SubhraJyotiDey/SmartTank-Dissertation/figures/system_schematic.png

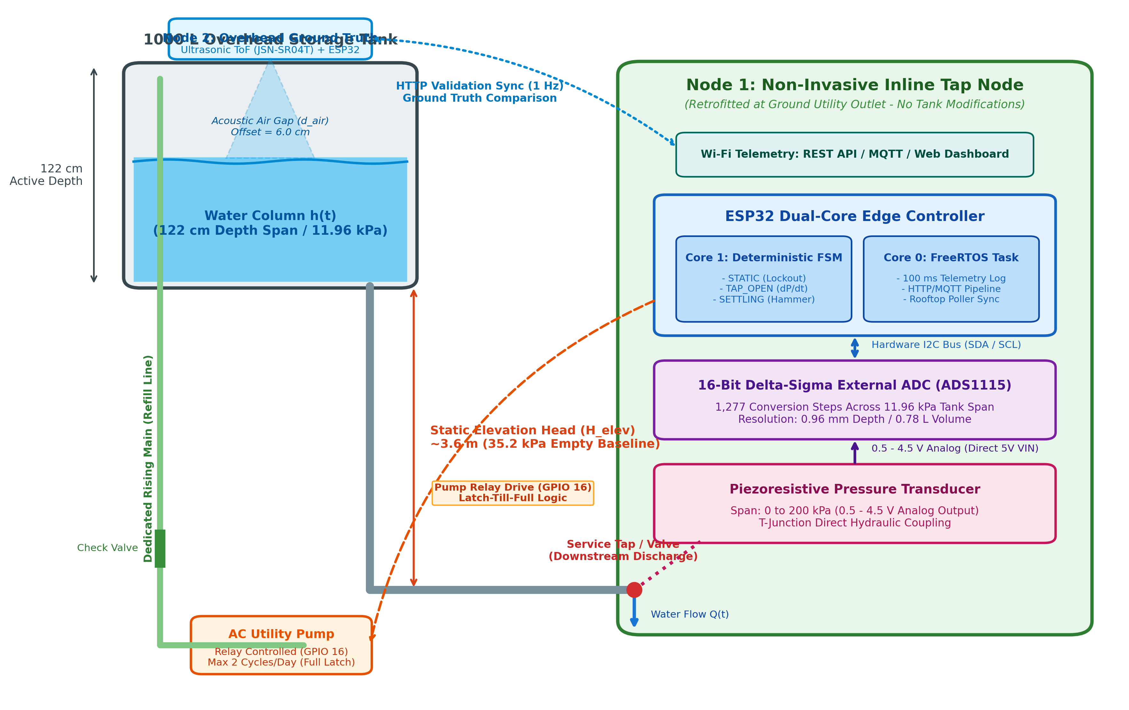
figures/system_schematic.png
