SubhraJyotiDey/SmartTank-Dissertation/plots/highres_events/00_master_highres_events_comparison.png

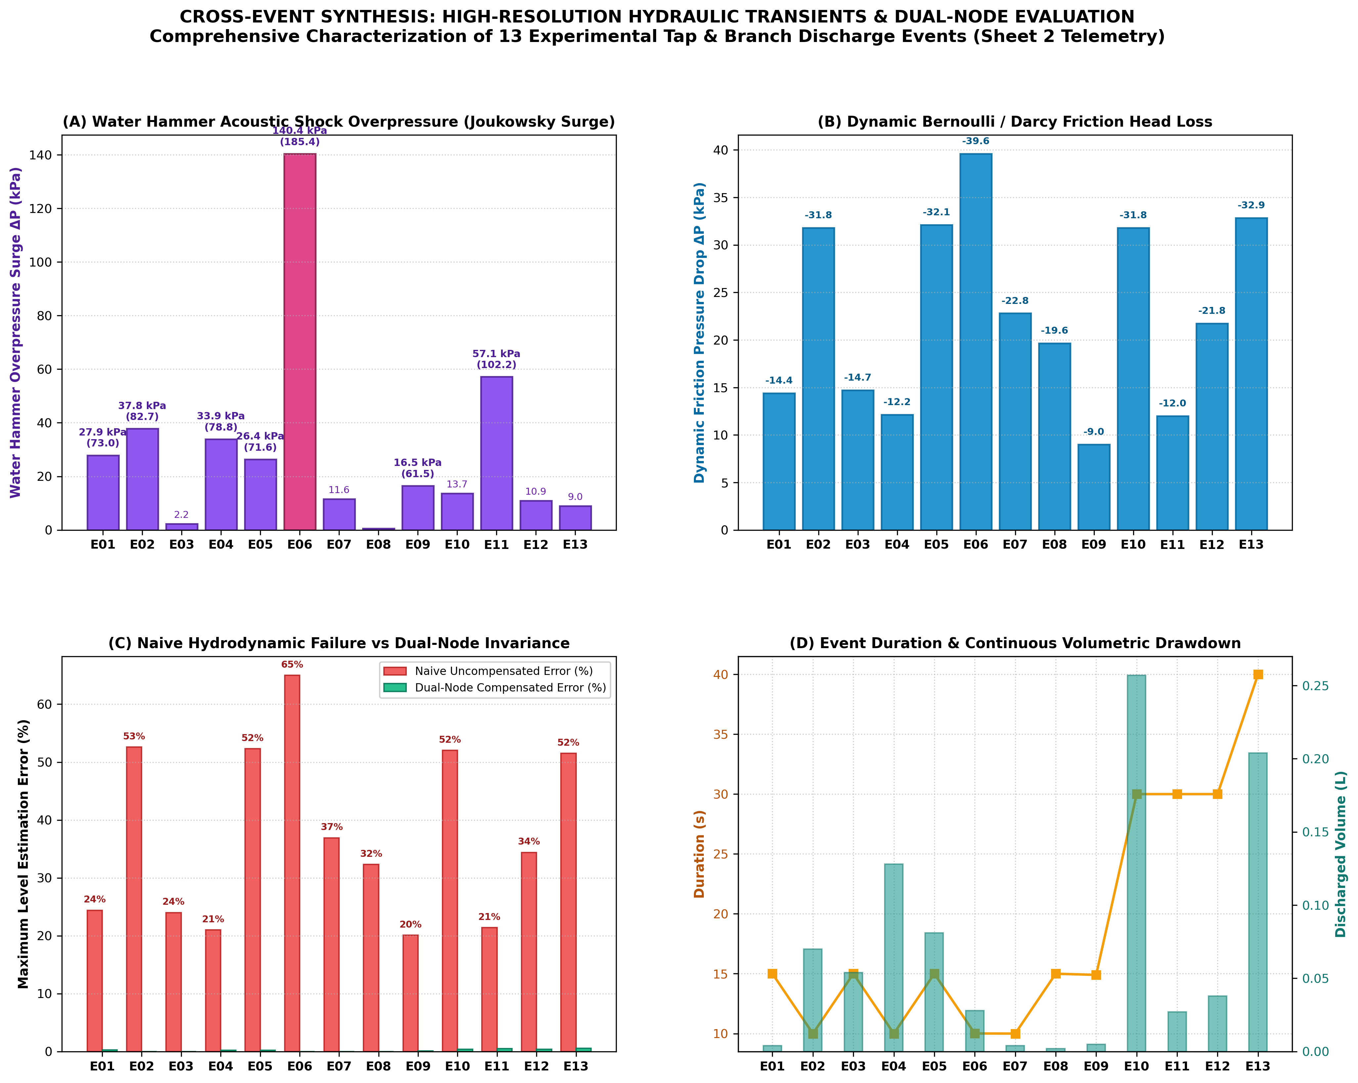
plots/highres_events/00_master_highres_events_comparison.png
