SubhraJyotiDey/SmartTank-Dissertation/plots/highres_events/event_01_EVT_1198_node_tap-1_open_only_5.png

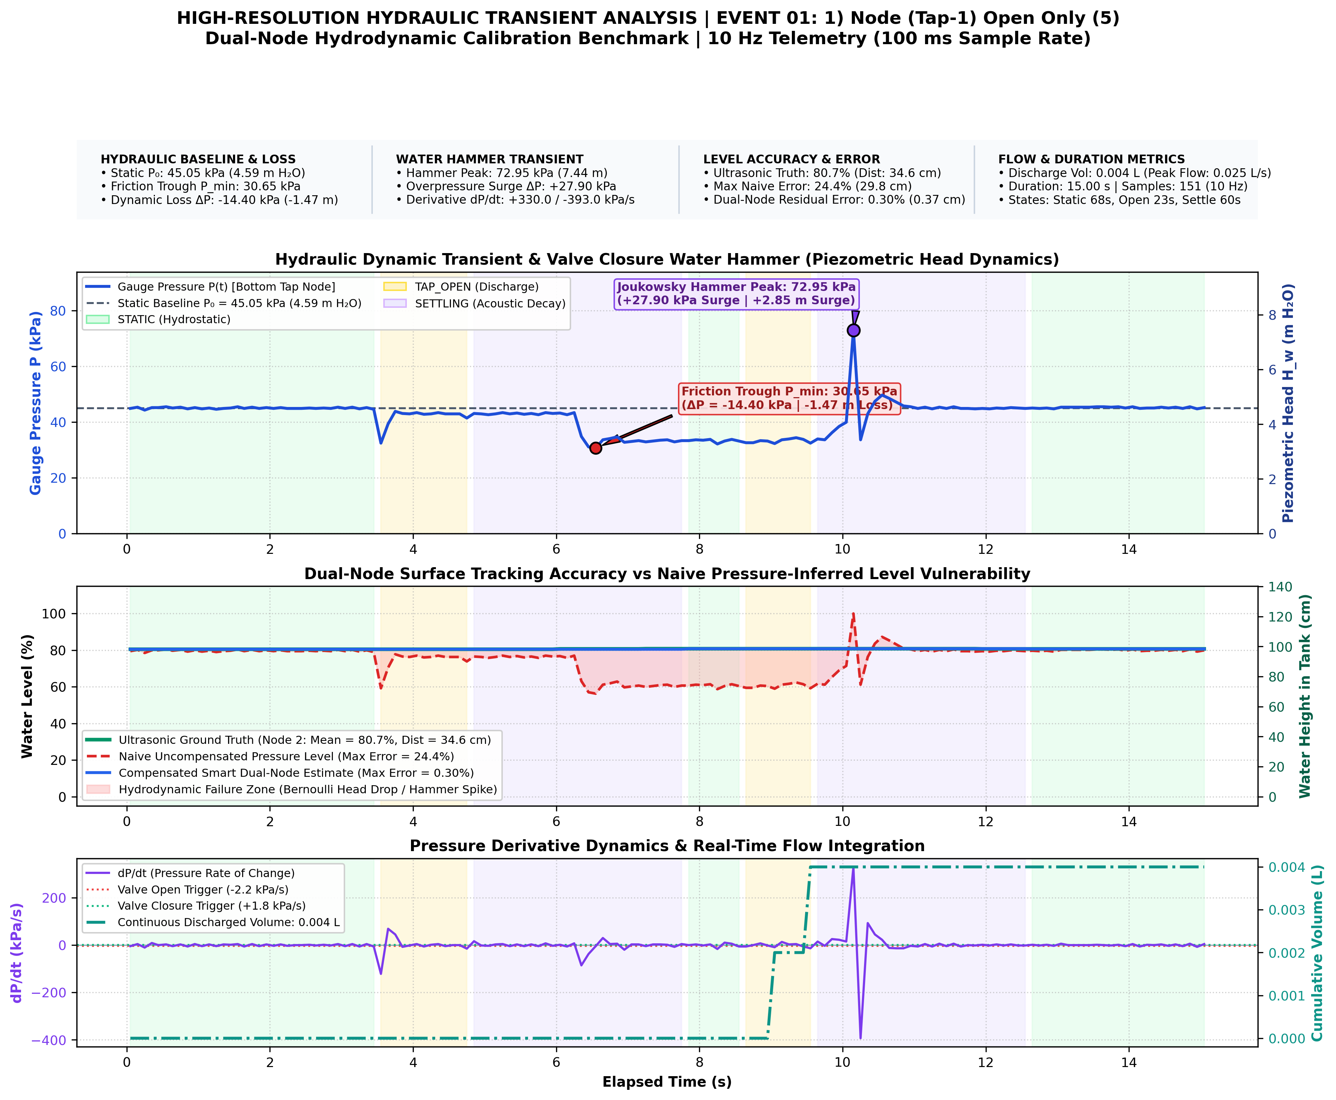
plots/highres_events/event_01_EVT_1198_node_tap-1_open_only_5.png
