SubhraJyotiDey/SmartTank-Dissertation/plots/highres_events/event_02_EVT_1728_node_tap-1_open_only_m.png

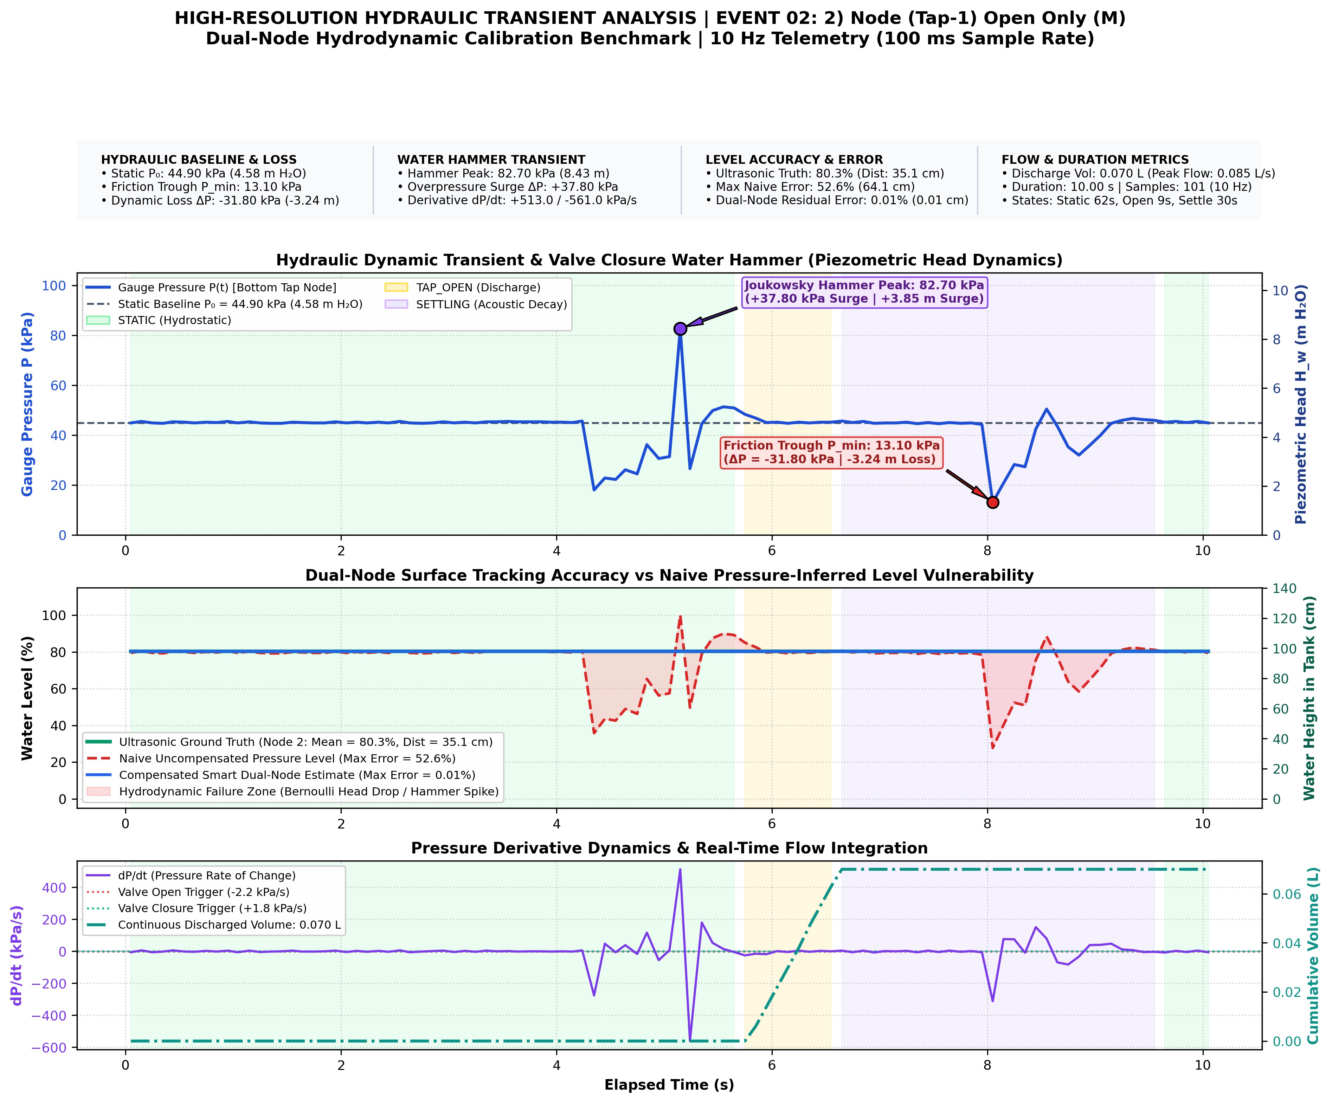
plots/highres_events/event_02_EVT_1728_node_tap-1_open_only_m.png
