SubhraJyotiDey/SmartTank-Dissertation/plots/highres_events/event_03_EVT_1934_tap-2_open_only_5s.png

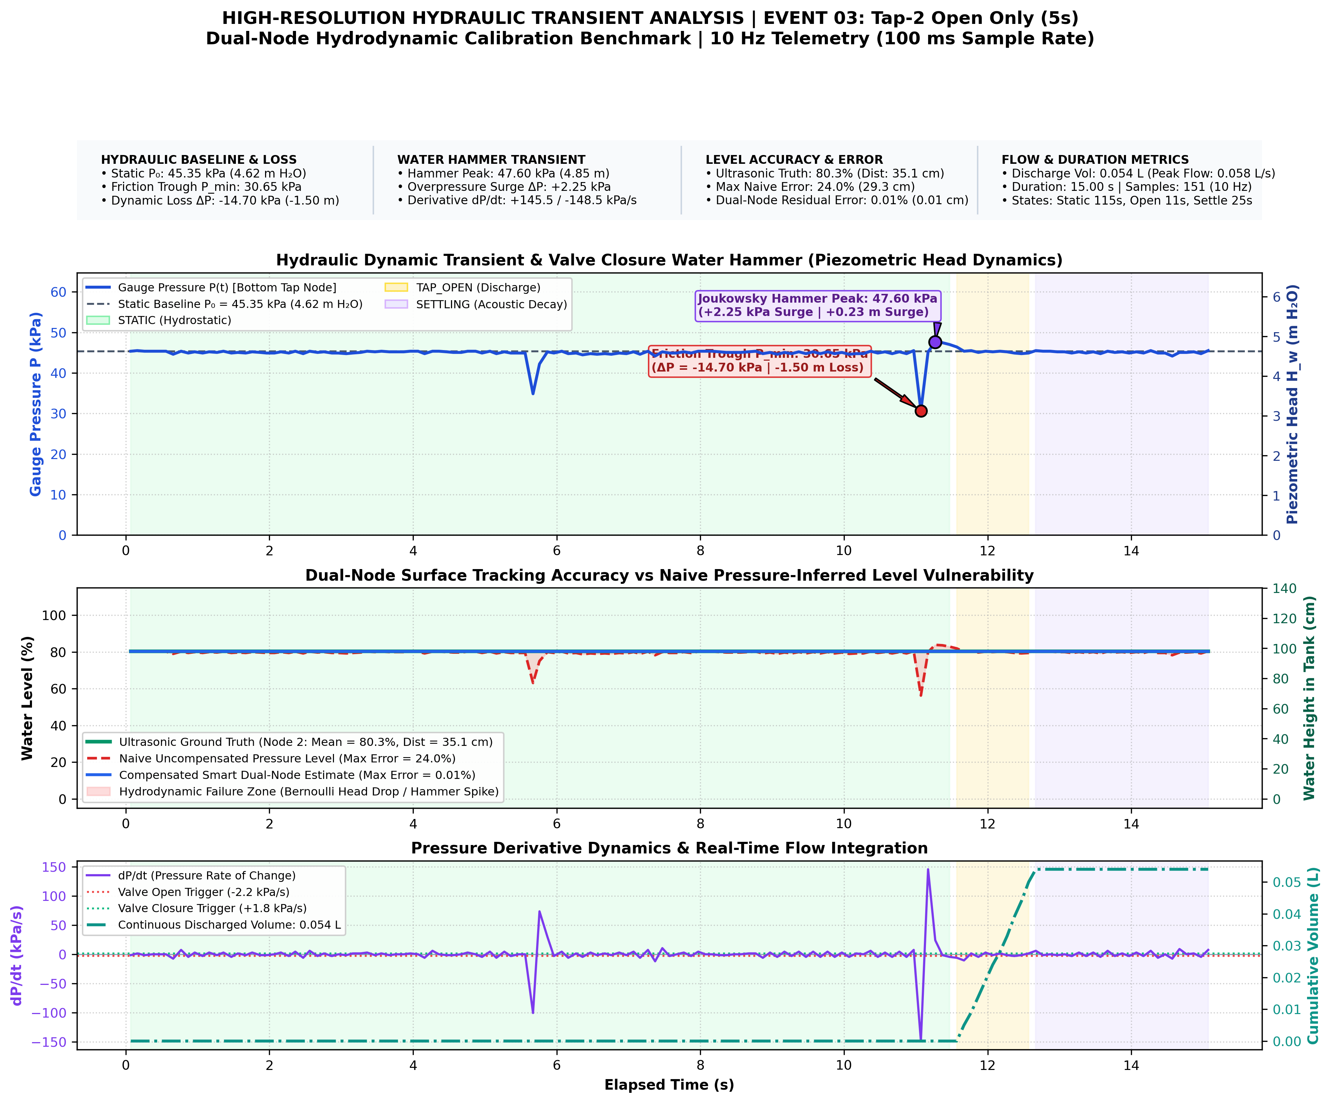
plots/highres_events/event_03_EVT_1934_tap-2_open_only_5s.png
