SubhraJyotiDey/SmartTank-Dissertation/plots/highres_events/event_04_EVT_1979_tap-2_open_only_m.png

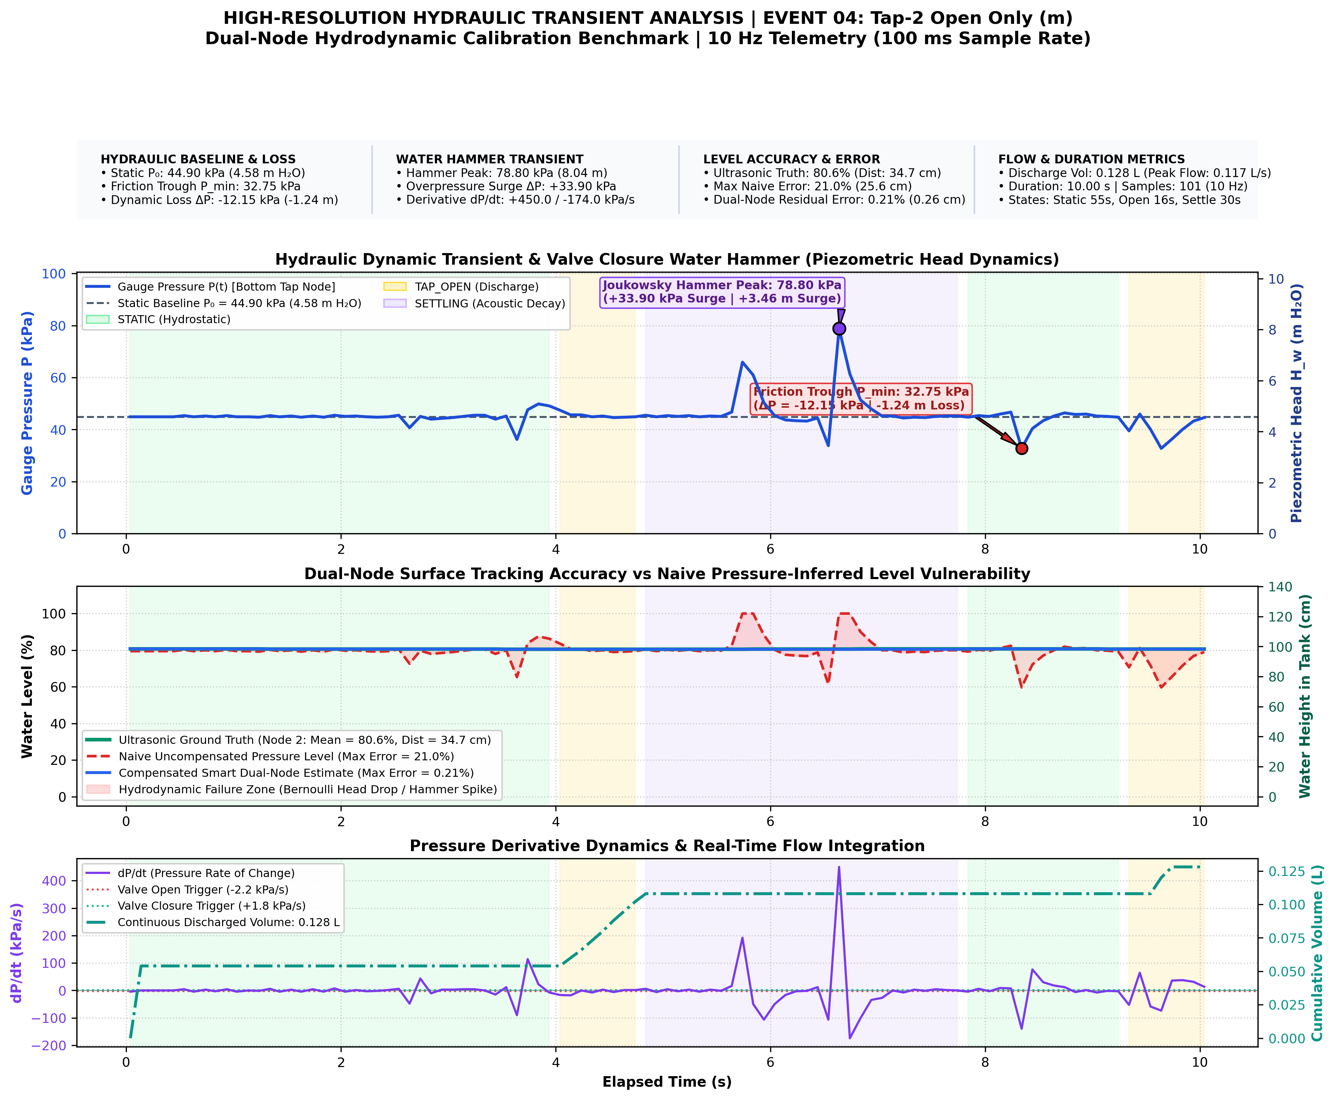
plots/highres_events/event_04_EVT_1979_tap-2_open_only_m.png
