SubhraJyotiDey/SmartTank-Dissertation/plots/highres_events/event_05_EVT_2163_both_taps_open_5s.png

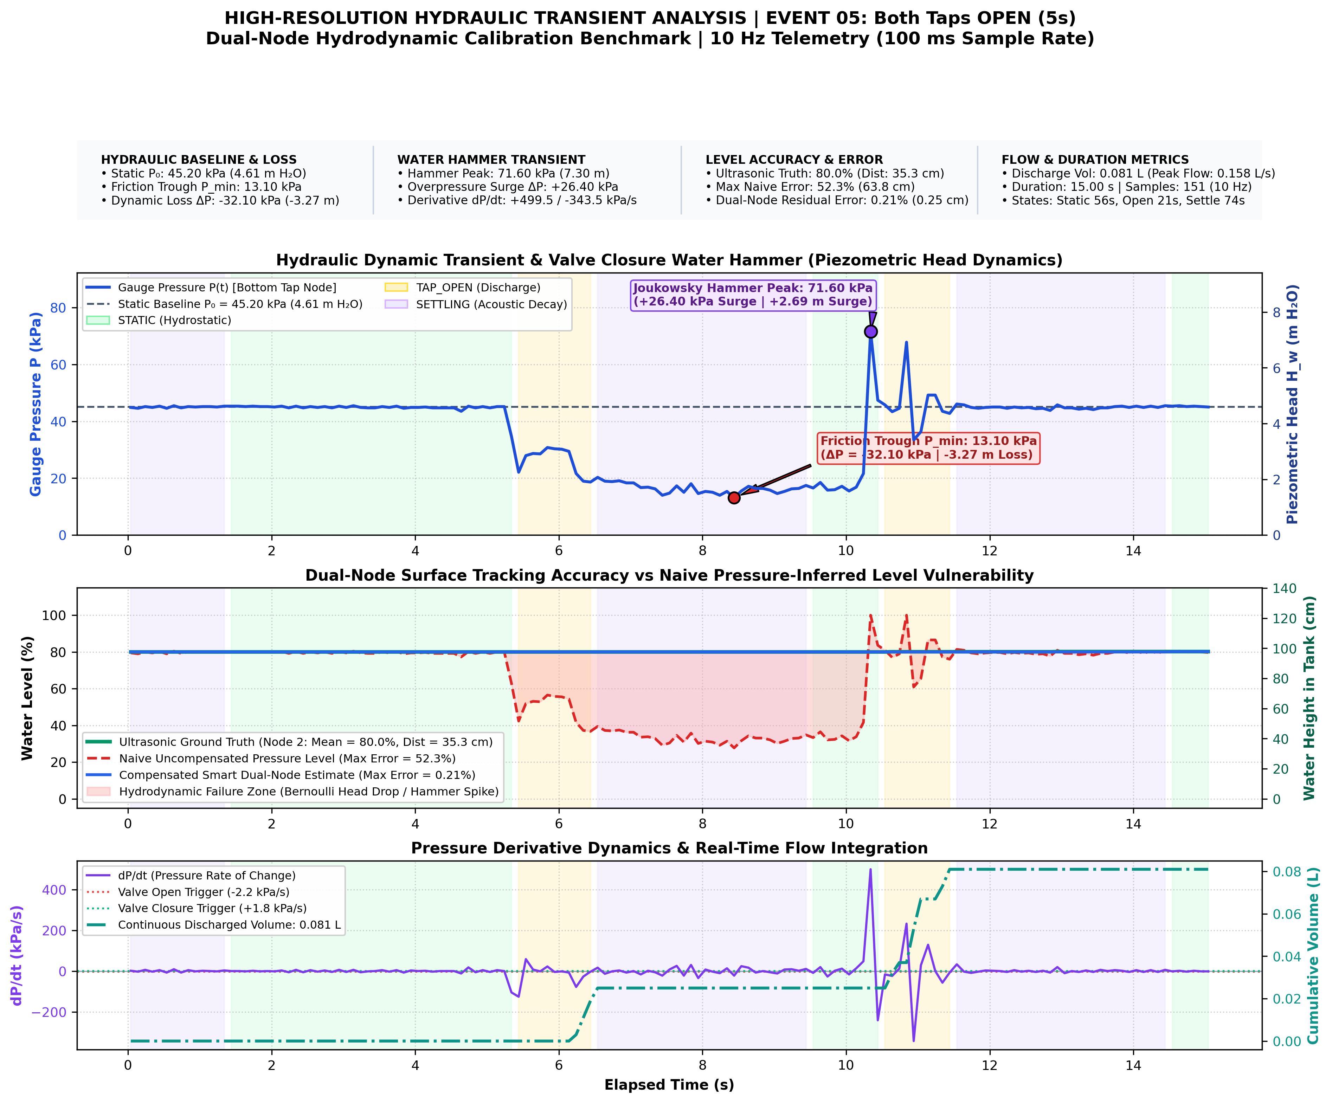
plots/highres_events/event_05_EVT_2163_both_taps_open_5s.png
