SubhraJyotiDey/SmartTank-Dissertation/plots/highres_events/event_06_EVT_2470_both_taps_open_m.png

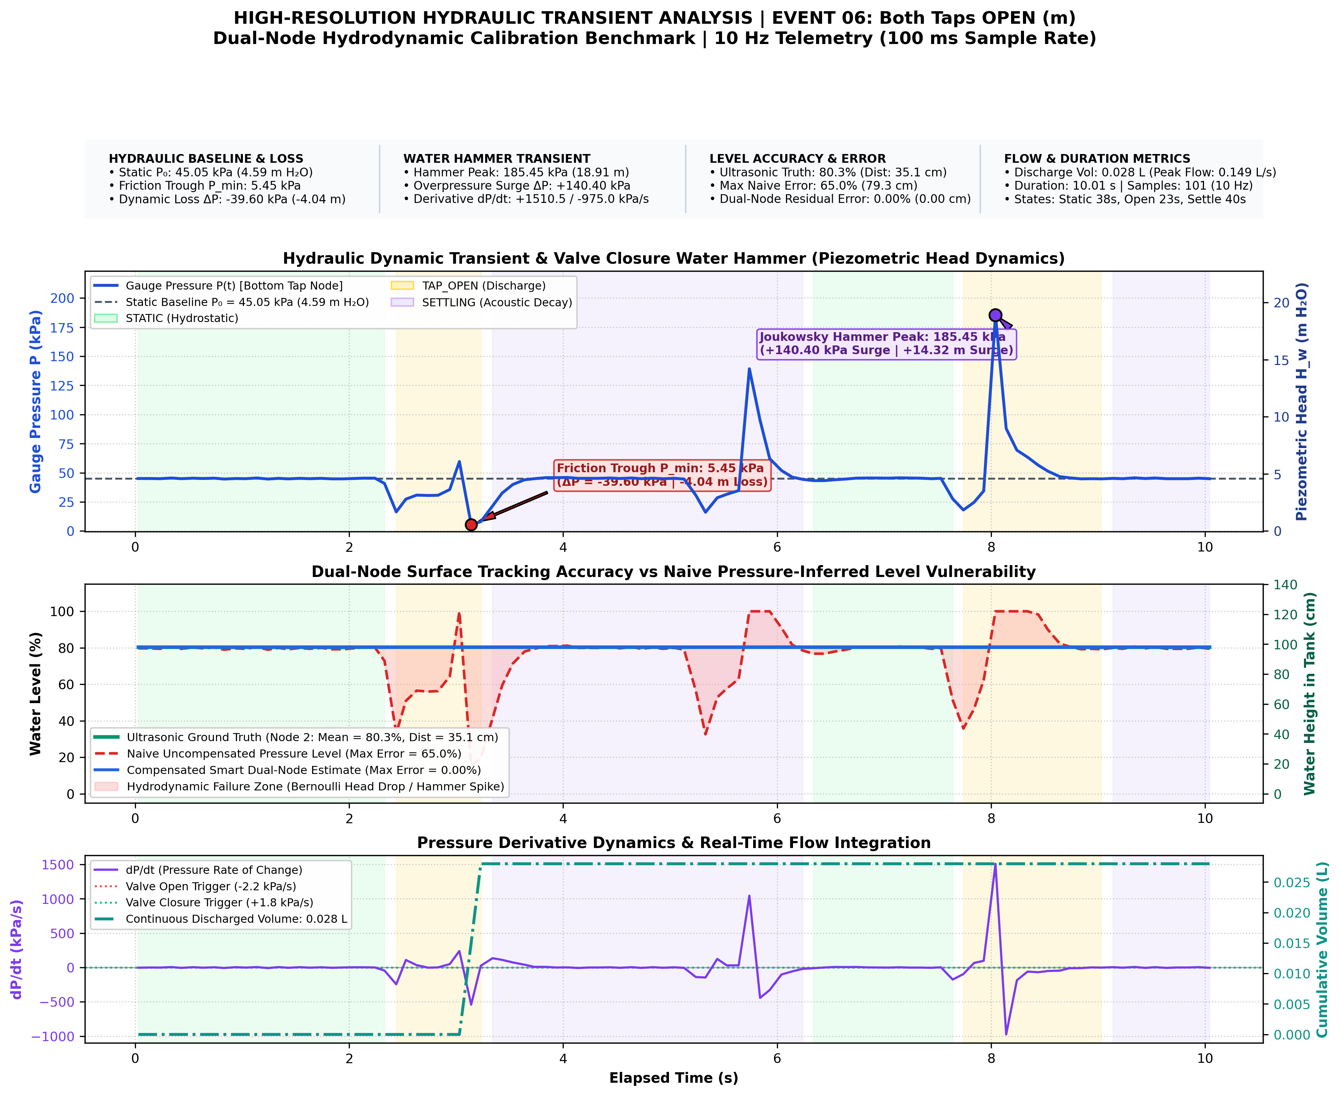
plots/highres_events/event_06_EVT_2470_both_taps_open_m.png
