SubhraJyotiDey/SmartTank-Dissertation/plots/highres_events/event_07_EVT_2779_branch_2_open_m.png

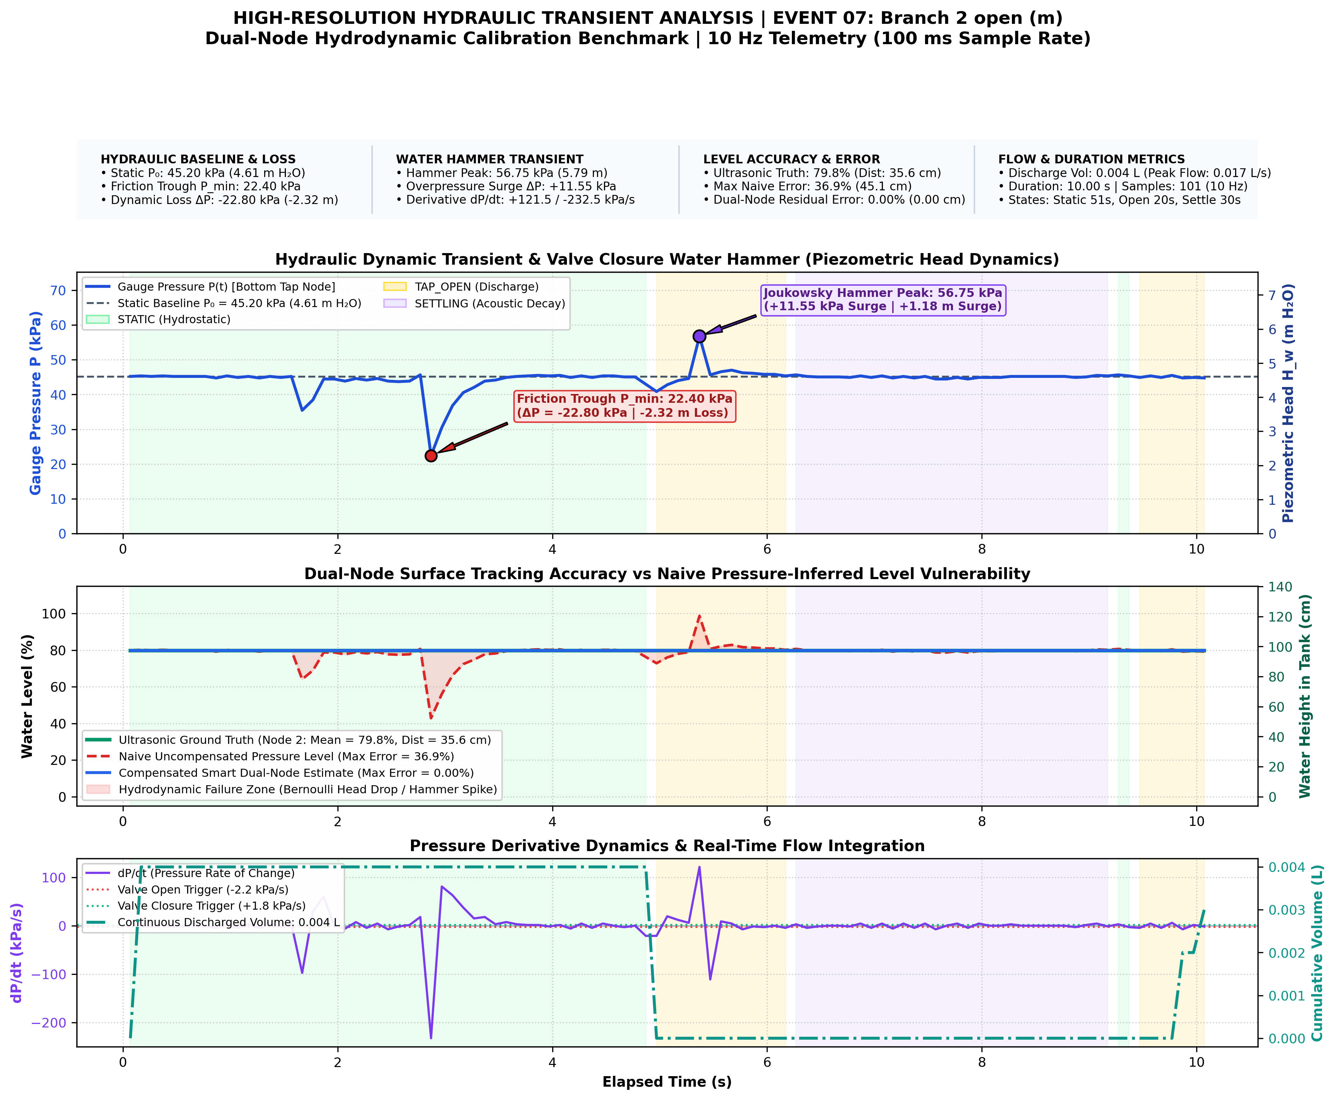
plots/highres_events/event_07_EVT_2779_branch_2_open_m.png
