SubhraJyotiDey/SmartTank-Dissertation/plots/highres_events/event_08_EVT_3347_branch_2_open_5s.png

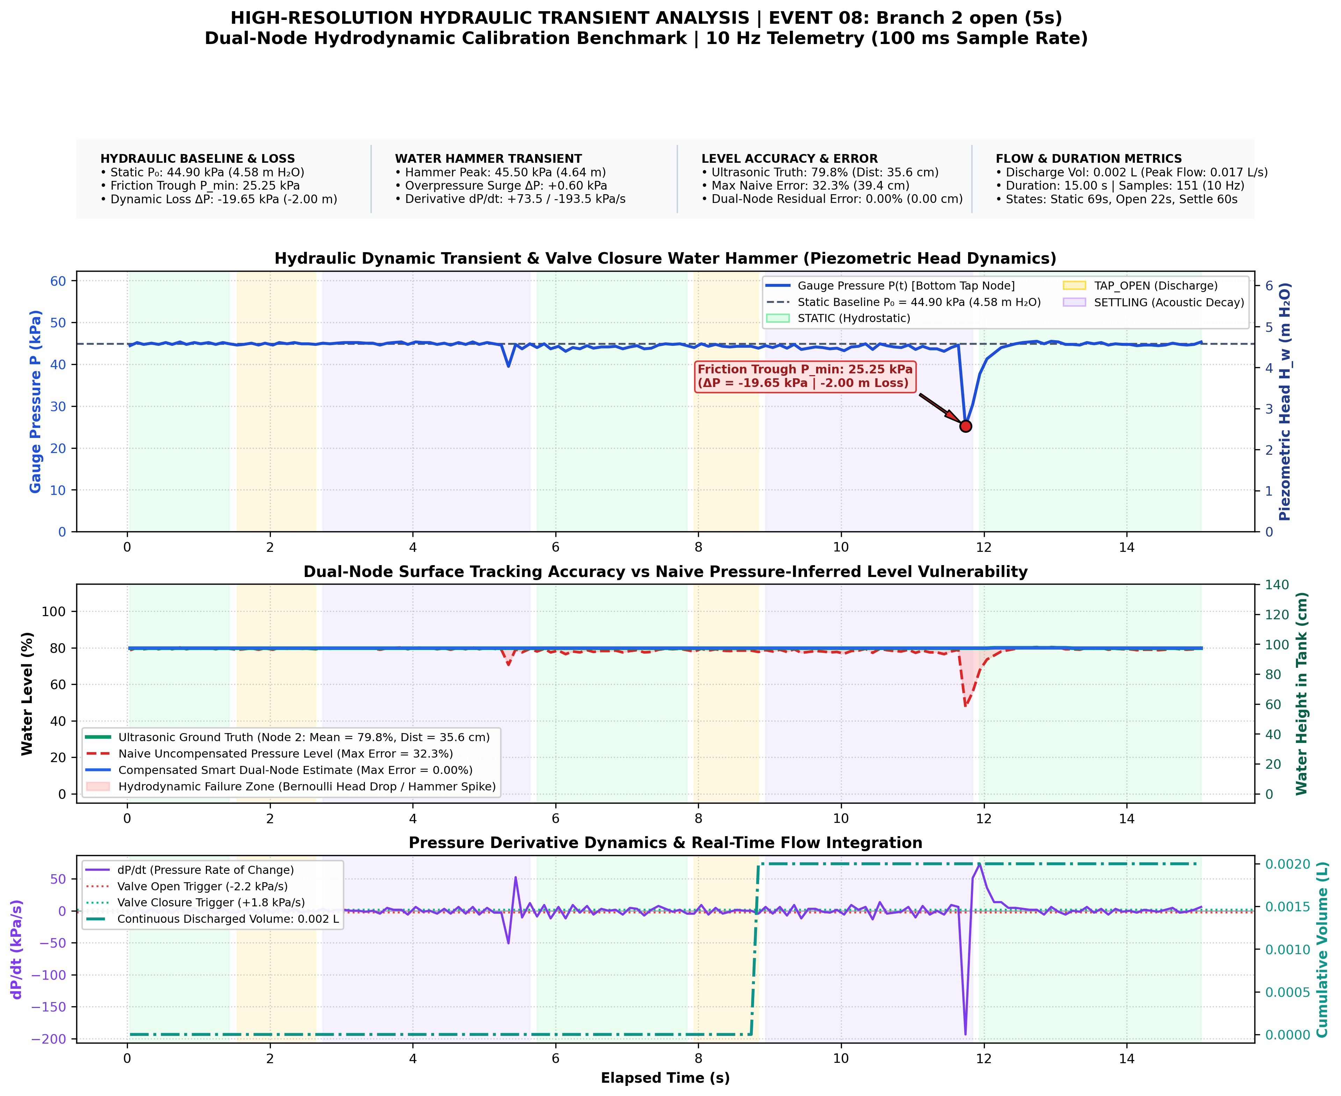
plots/highres_events/event_08_EVT_3347_branch_2_open_5s.png
