SubhraJyotiDey/SmartTank-Dissertation/plots/highres_events/event_09_EVT_3409_branch_3_basin_open_5s.png

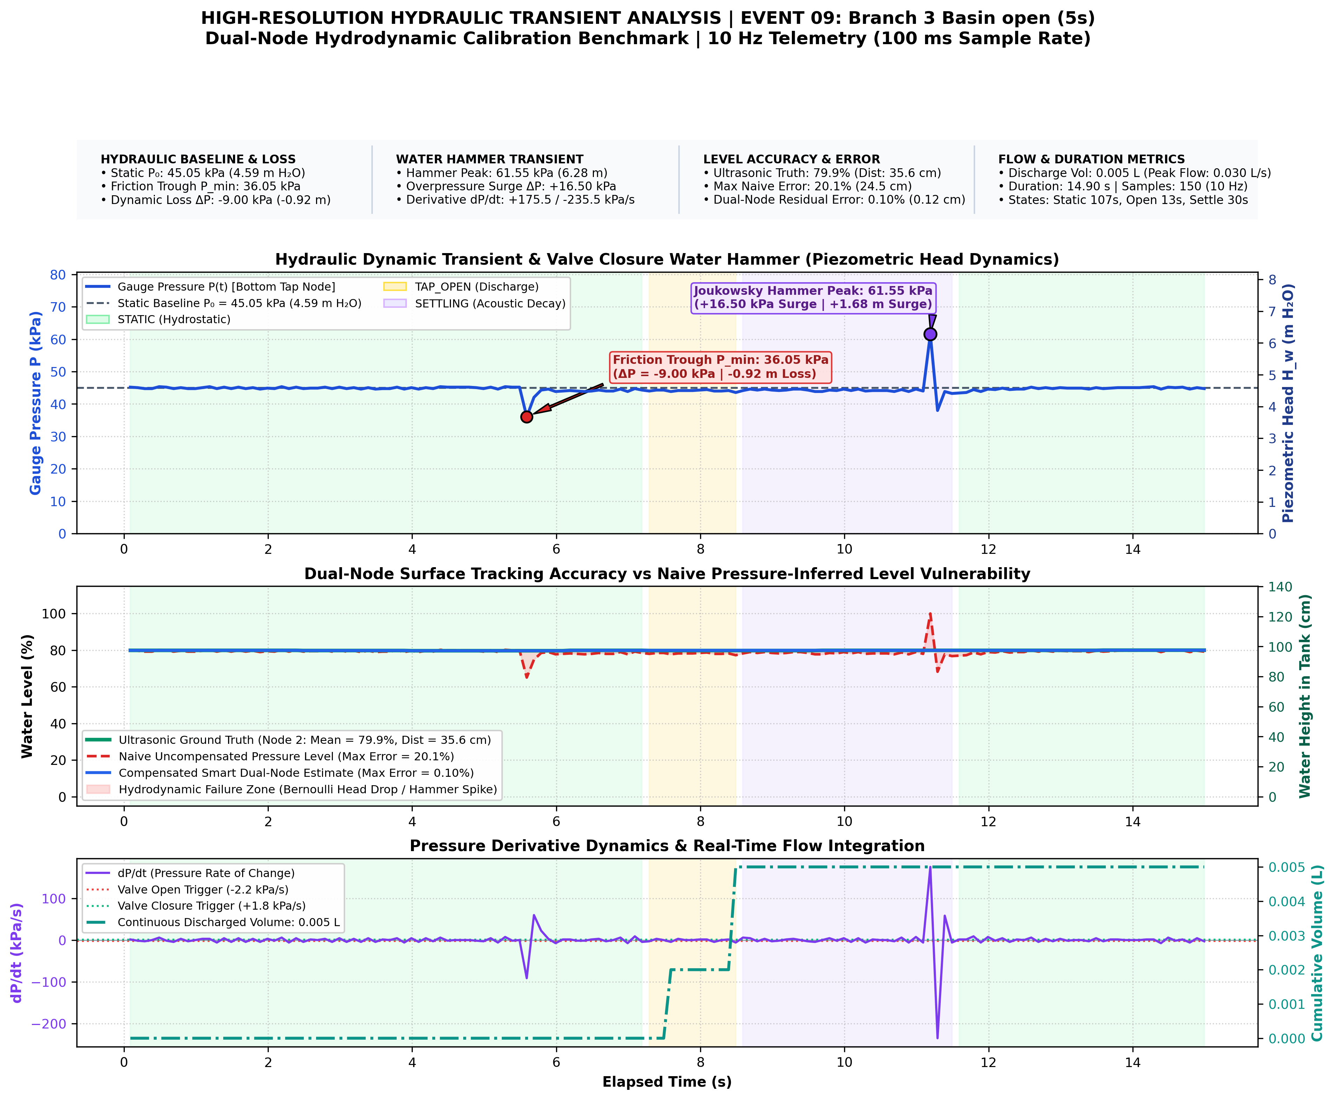
plots/highres_events/event_09_EVT_3409_branch_3_basin_open_5s.png
