SubhraJyotiDey/SmartTank-Dissertation/plots/highres_events/event_10_EVT_3598_all_branches_open_20s.png

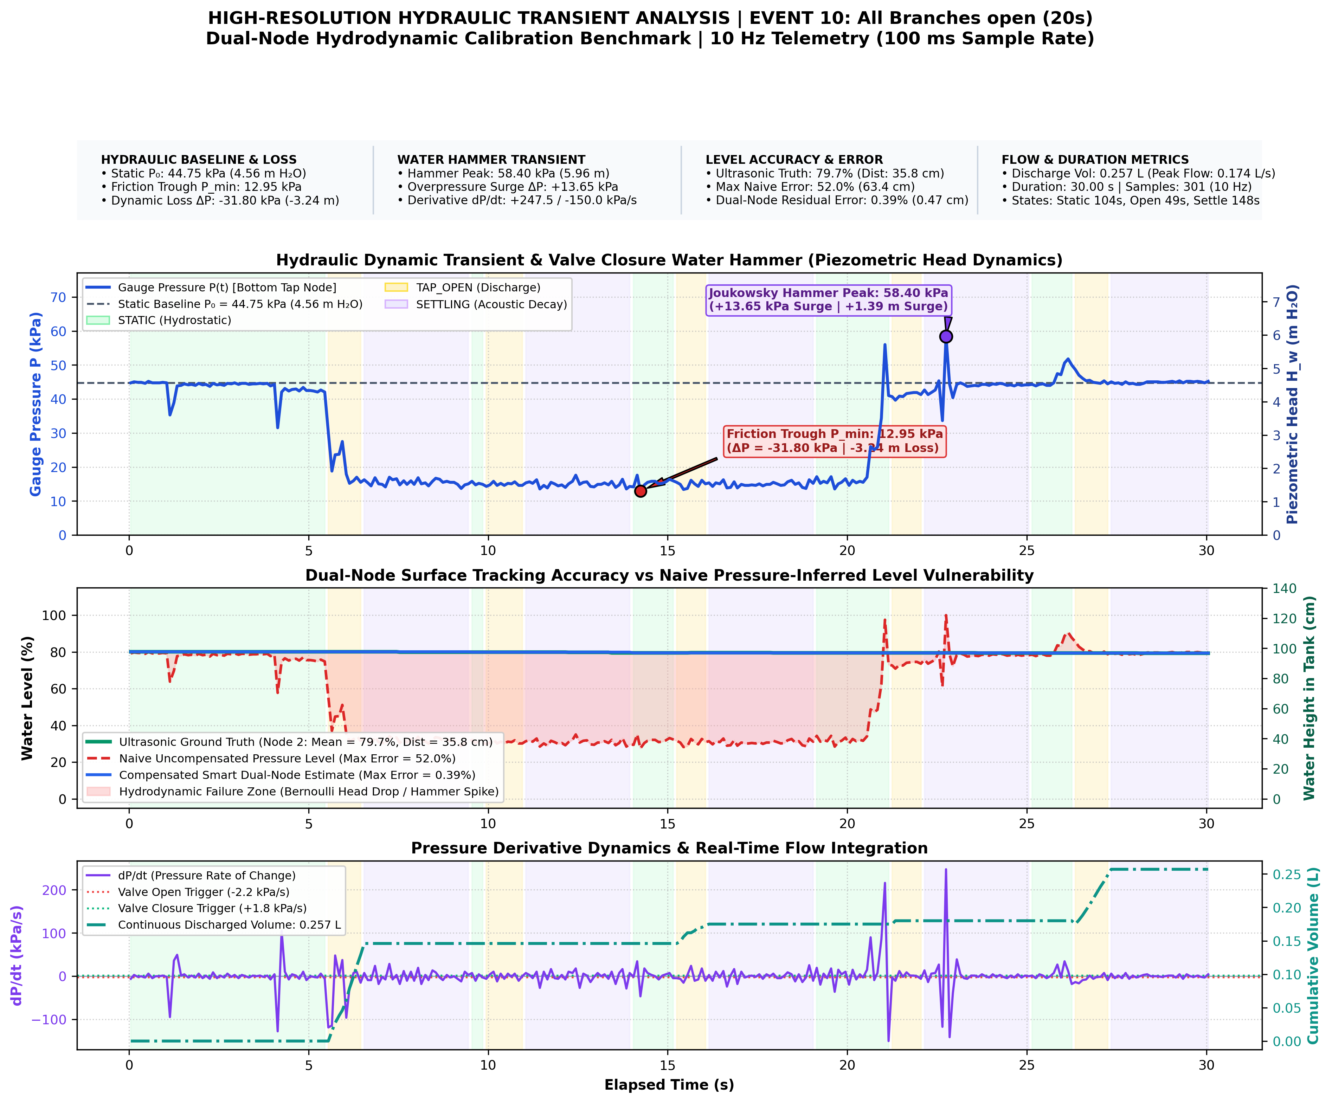
plots/highres_events/event_10_EVT_3598_all_branches_open_20s.png
