SubhraJyotiDey/SmartTank-Dissertation/plots/highres_events/event_11_EVT_3949_branch_2-3_open_10s.png

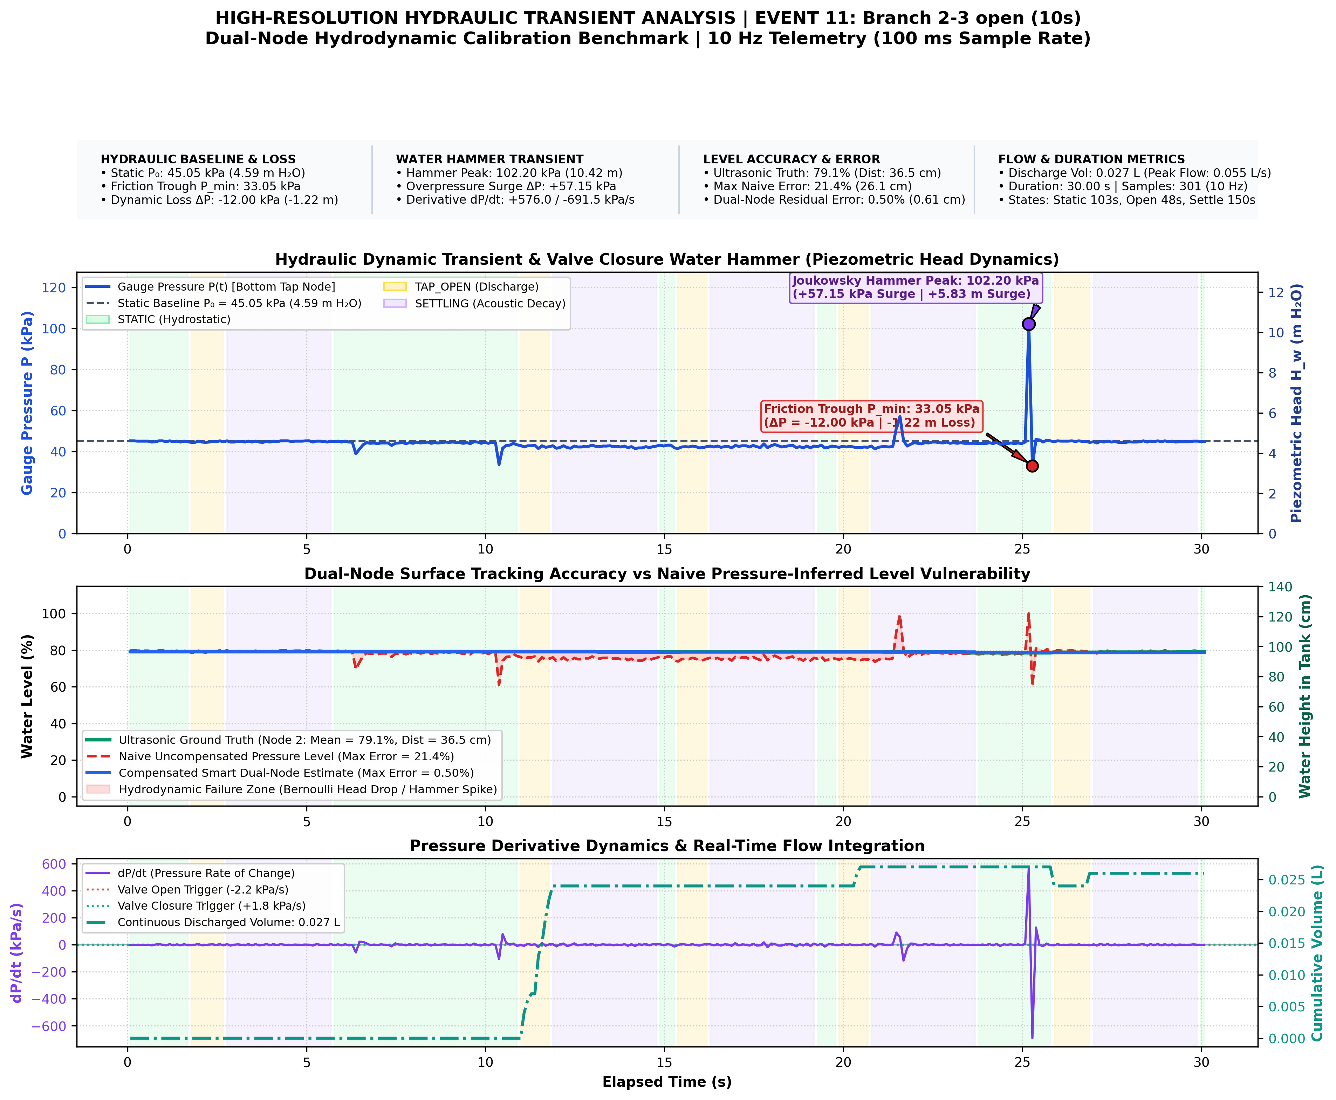
plots/highres_events/event_11_EVT_3949_branch_2-3_open_10s.png
