SubhraJyotiDey/SmartTank-Dissertation/plots/highres_events/event_12_EVT_4065_branch_1-2_open_10s.png

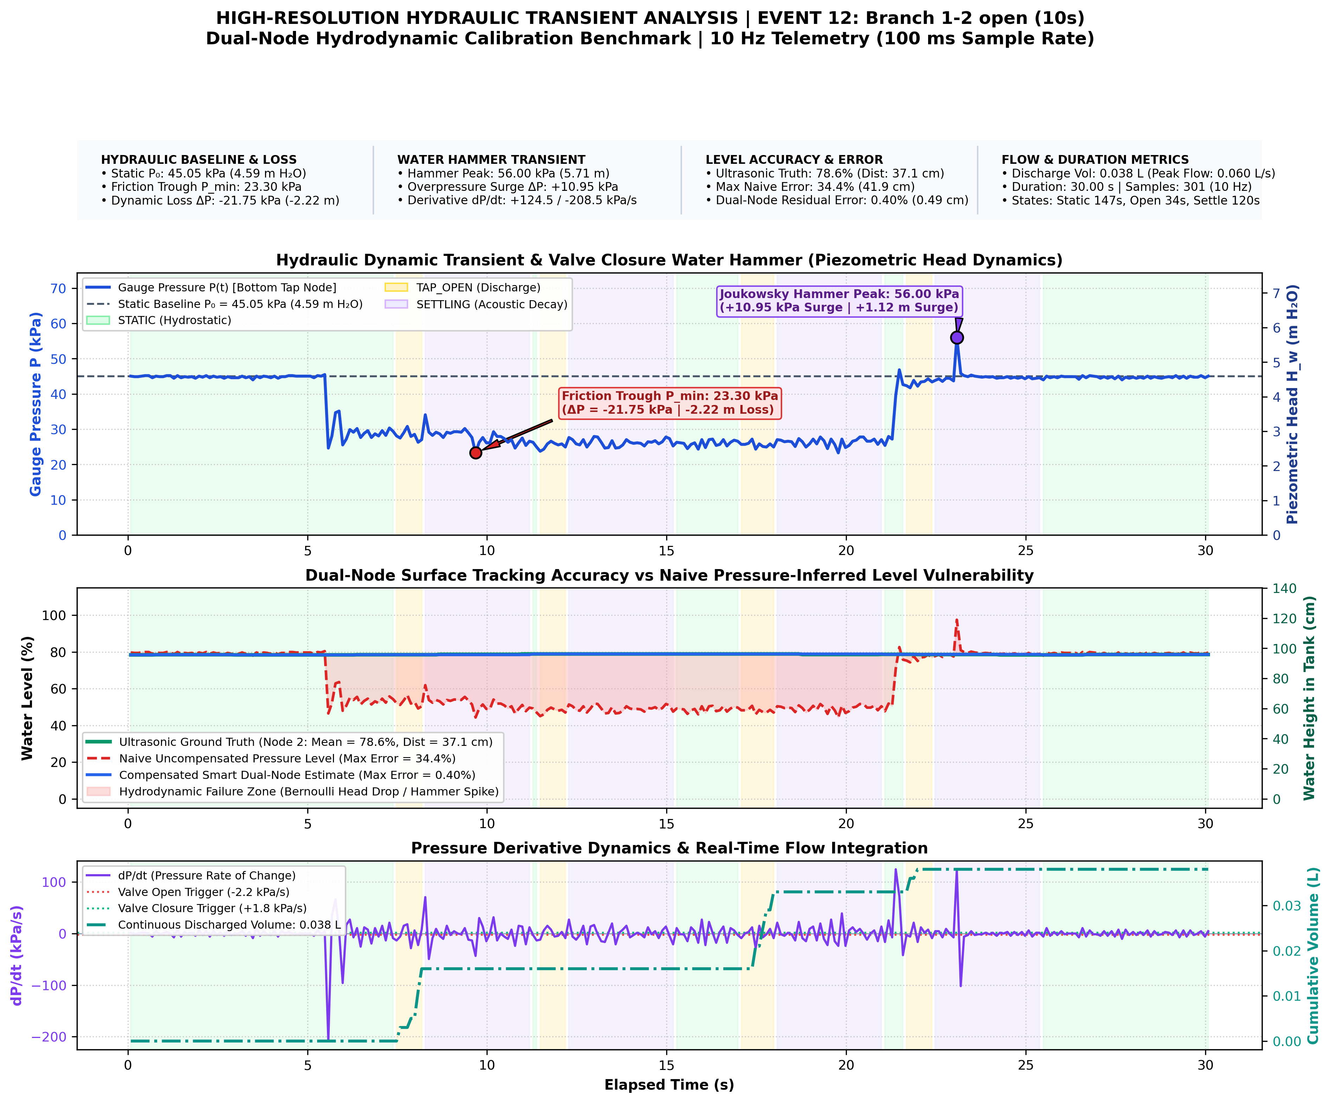
plots/highres_events/event_12_EVT_4065_branch_1-2_open_10s.png
