SubhraJyotiDey/SmartTank-Dissertation/plots/highres_events/event_13_EVT_4303_branch_1-3_open_10s.png

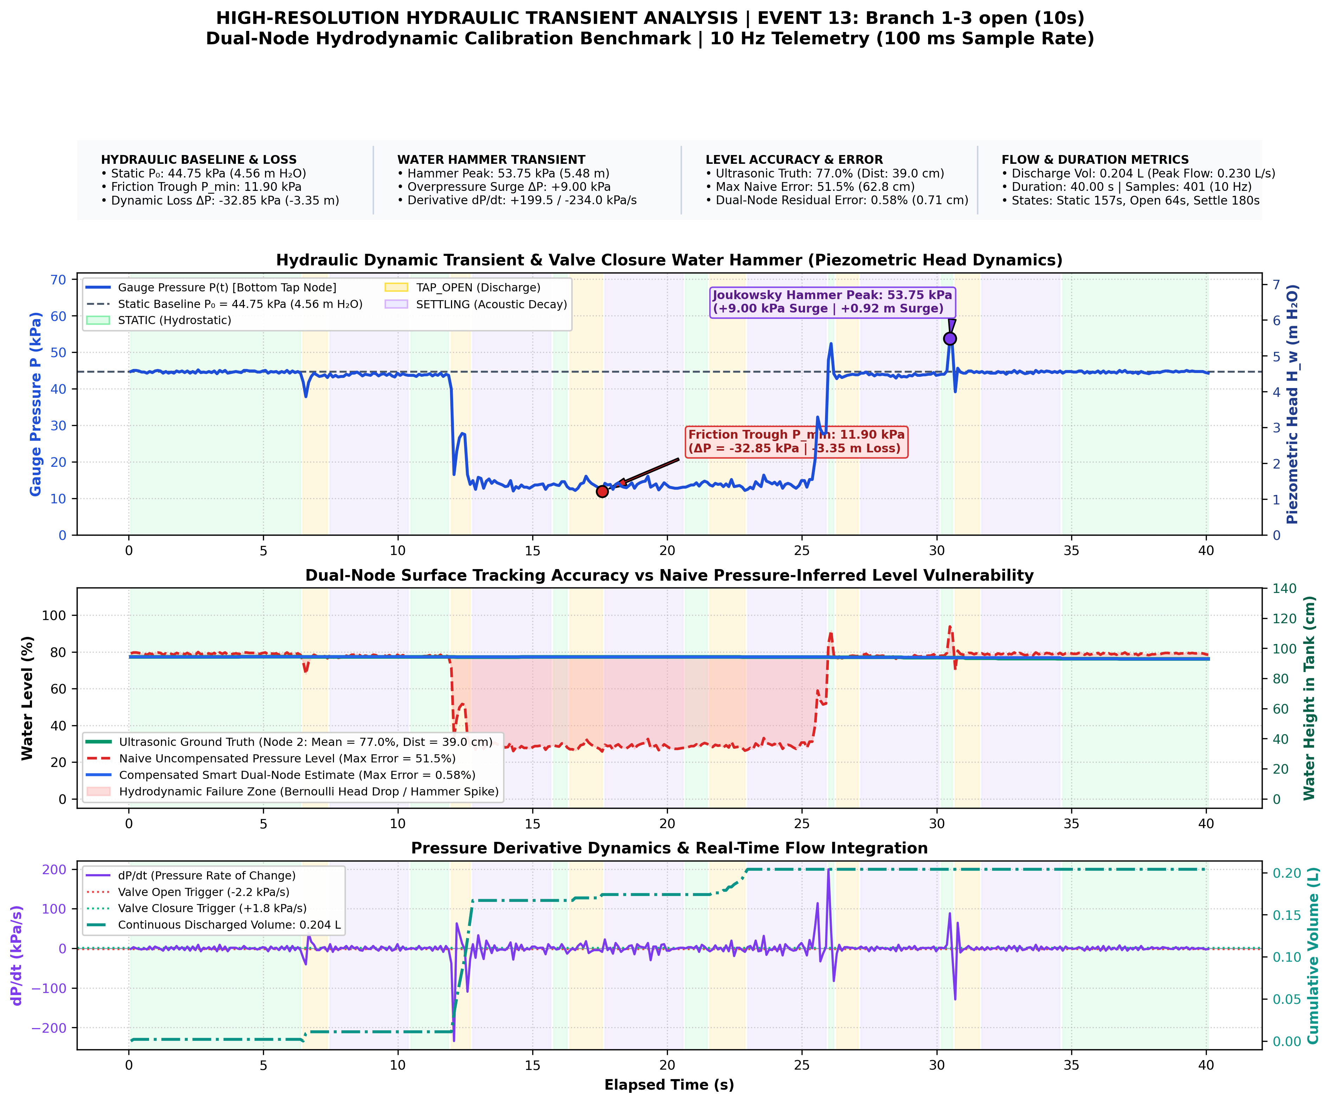
plots/highres_events/event_13_EVT_4303_branch_1-3_open_10s.png
