SubhraJyotiDey/SmartTank-Dissertation/system_block_diagram.png

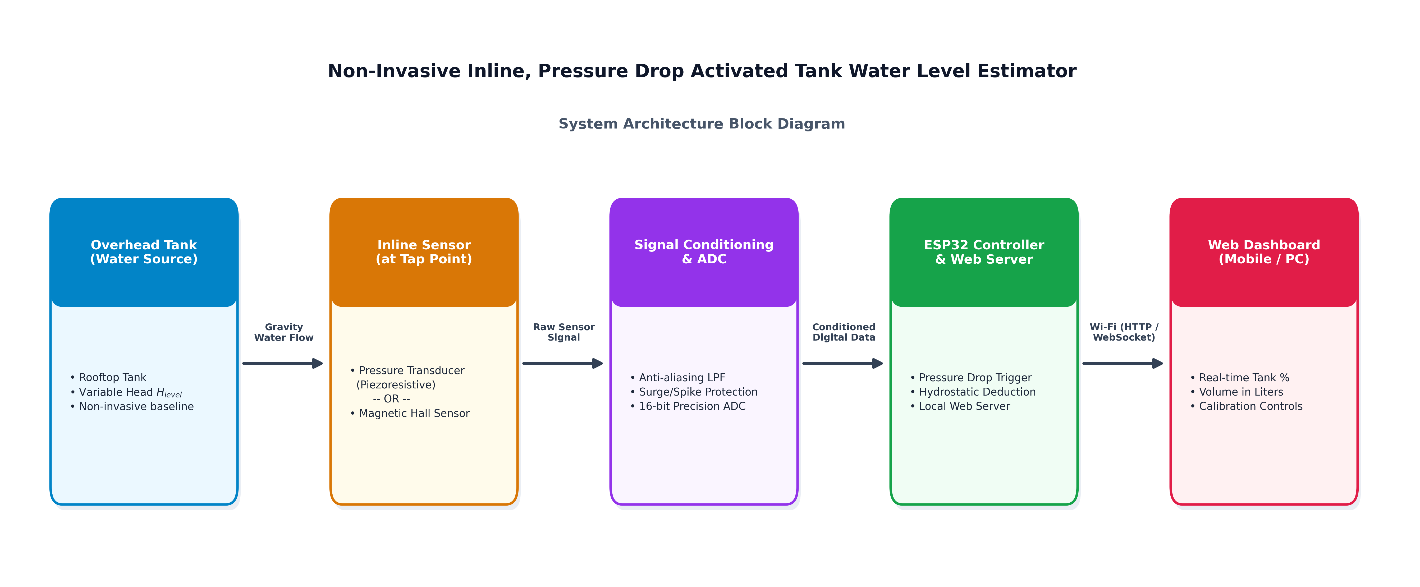
system_block_diagram.png
