SubhraJyotiDey/SmartTank-Dissertation/water_level_comparison_rows_1138_1474.png

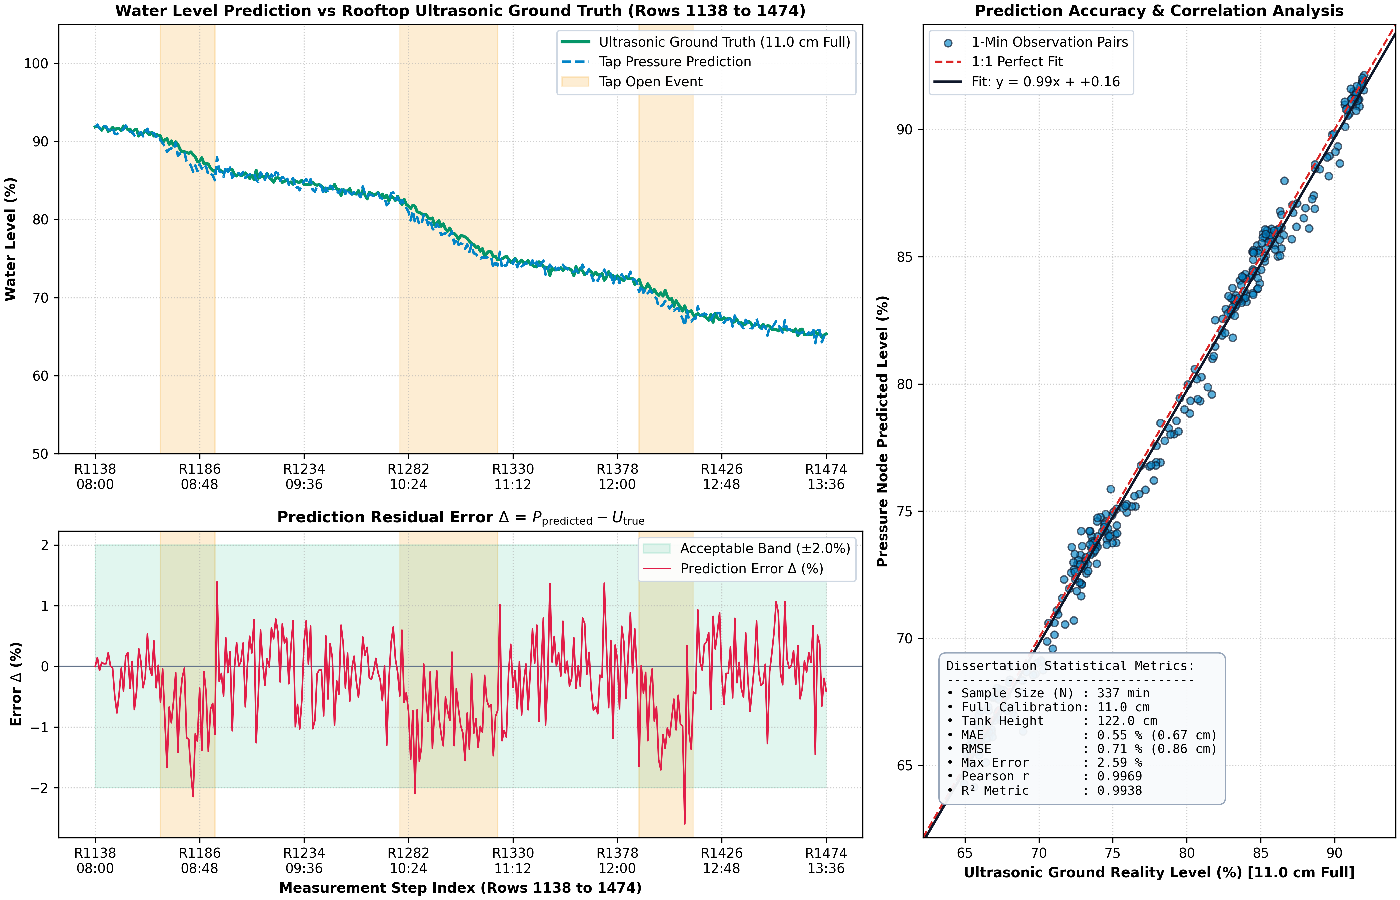
water_level_comparison_rows_1138_1474.png
