SubhraJyotiDey/SmartTank-Dissertation/water_level_comparison_rows_2283_2654.png

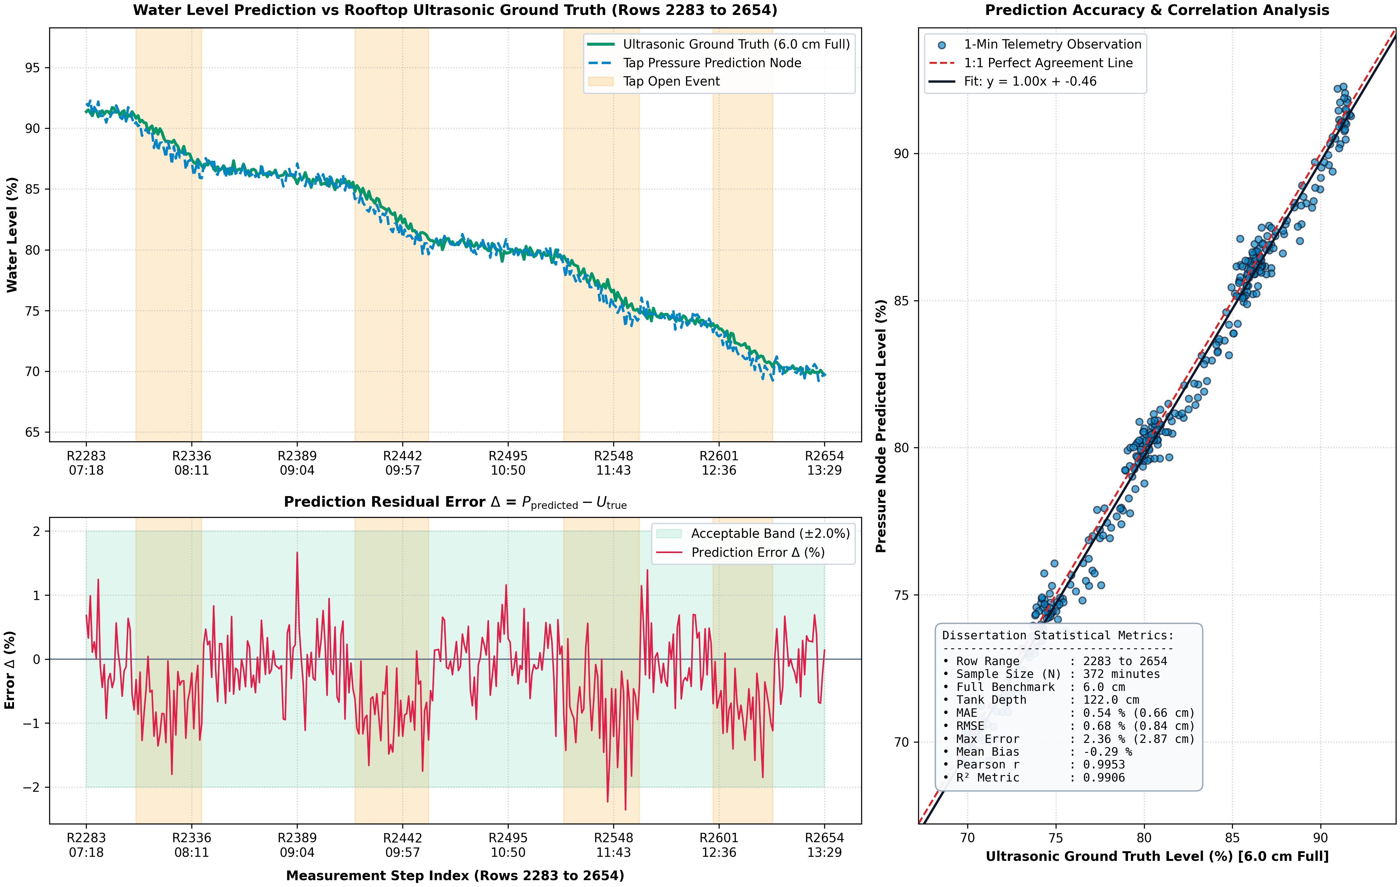
water_level_comparison_rows_2283_2654.png
