SubhraJyotiDey/SmartTank-Dissertation/simulation/simulation_results.png

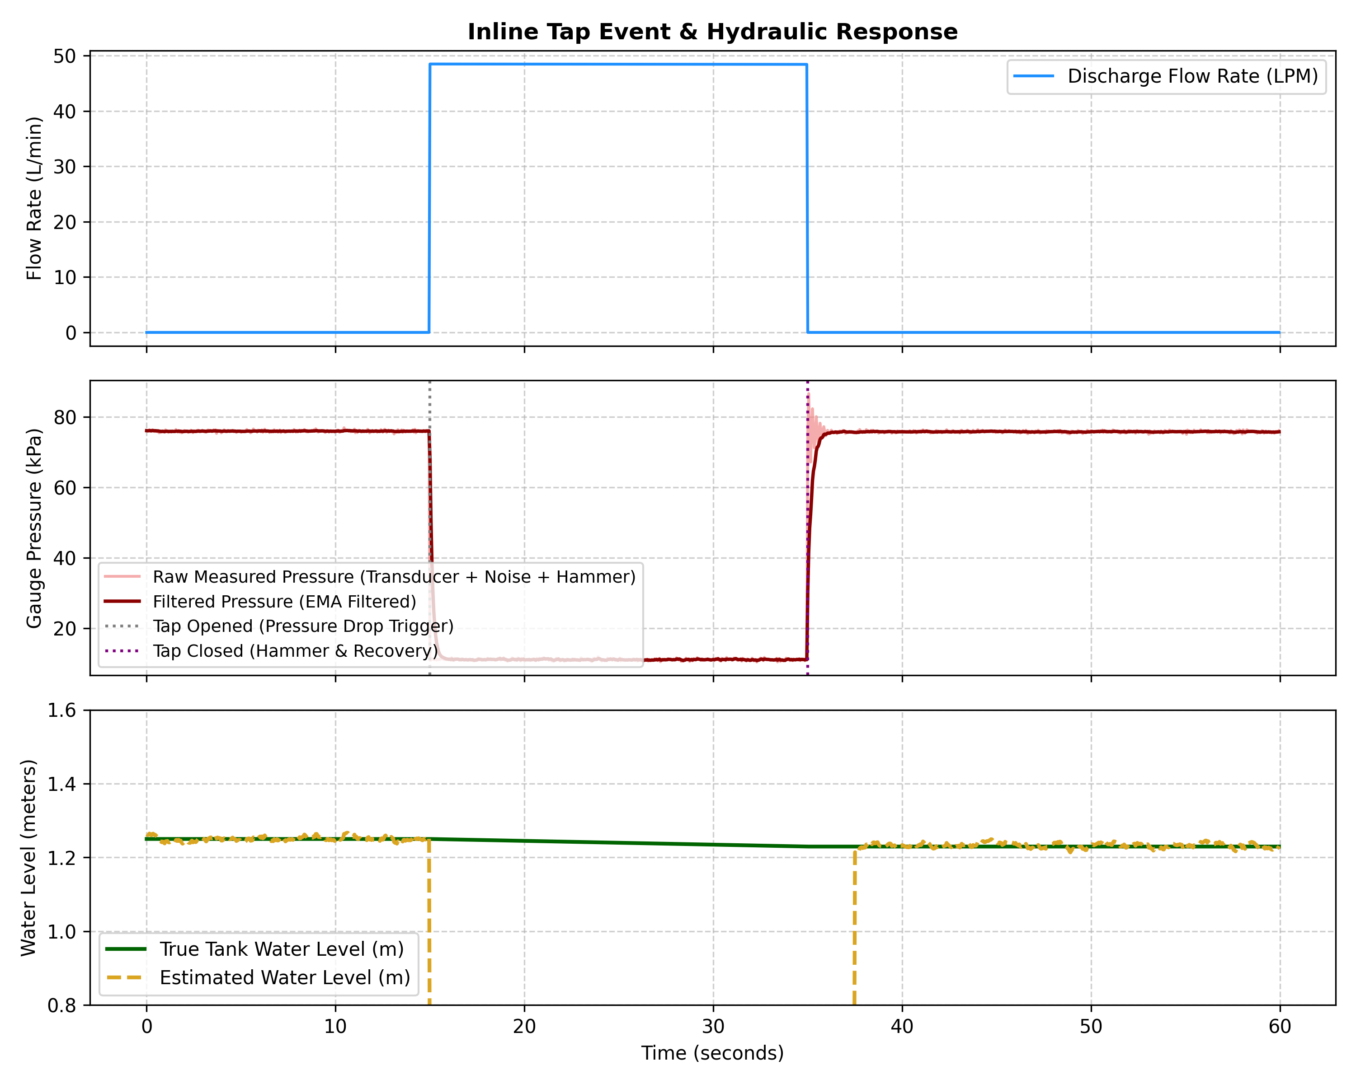
simulation/simulation_results.png
