SubhraJyotiDey/SmartTank-Dissertation/(commit log)

2026-10-28 Initial commit: ESP32 Smart Tank monitoring and calibration system
2026-10-28 Add GitHub Actions CI to auto-compile ESP32 firmware binaries
2026-10-28 Implement 10 Hz High-Resolution Event Capture, Sheet 2 logging, pastel event color coding, and local Web Dashboard controller at 192.168.29.125
2026-10-28 Fix flowRateLps scope and unused variable in esp32_pressure_tap_node.ino
    [esp32_pressure_tap_node.ino]
2026-10-28 Fix GitHub 302 redirect handling and Authorization header for Azure binary asset download in cloud_ota_updater.h
    [cloud_ota_updater.h]
2026-10-28 Remove digital filters and deadbands for direct 1:1 hardware ADC gauge output (v1.2.1)
2026-10-28 Fix release asset API URL extraction for private repository Cloud OTA download
    [cloud_ota_updater.h]
2026-10-28 Decouple rooftop ultrasonic fetch to Core 0 background task for rock-solid 10 Hz sampling
2026-10-28 Fix OTA check so manual check compares versions instead of forcing redundant reflash; use getLocation with heap dealloc delay
    [cloud_ota_updater.h, esp32_pressure_tap_node.ino]
2026-10-28 Activate Bidirectional Cloud MQTT Command Listener on ESP32 and Deploy Global Dashboard to GitHub Pages (v1.2.4)
2026-10-28 Add Node 2 remote reboot, custom sheet/row selection in Sheets, Subhra Jyoti Dey author branding, dotted ultrasound line, and ultrasound metric boxes (v1.2.5)
    [esp32_pressure_tap_node.ino, esp32_ultrasonic_tank_node.ino]
2026-10-30 Add immediate Cloud OTA update buttons, fix 60cm ultrasonic freeze, and eliminate telemetry flickering (v1.2.6)
    [cloud_ota_updater.h, esp32_pressure_tap_node.ino, esp32_ultrasonic_tank_node.ino, highres_event_recorder.h]
2026-10-30 Add Cache-Control headers and meta tags to prevent stale dashboard caching
    [cloud_ota_updater.h, esp32_pressure_tap_node.ino, esp32_ultrasonic_tank_node.ino]
2026-11-08 Add Node 3 pump relay firmware, multi-role cooperative cluster protocol, and PIN 7431 pump switch to GitHub dashboard
2026-11-08 Add PIN 7431 pump switch to local web_dashboard.h and fix GitHub Pages cloud link
2026-11-08 security: Obscure authorization PIN from front-end and hash verification
2026-11-09 Fix offline bulk upload and queue rollback on Wi-Fi reconnect (v1.2.8)
    [esp32_pressure_tap_node.ino, esp32_ultrasonic_tank_node.ino]
2026-11-09 feat: Add Node 3 LED signaling, dynamic ESP-NOW peer discovery, Node 2 ESP-NOW telemetry & overflow cutoff, and Floor 1 sheets support
2026-11-09 perf: 10Hz smooth digital oscilloscope sweep engine without lag
2026-11-09 fix: Non-blocking incremental offline drain and prevent fake history injection into oscilloscope
    [esp32_pressure_tap_node.ino]
2026-11-09 feat(cluster): Node 1 & Node 3 v1.2.8 with dual-path pump control, keepalive watchdog feed, and clean OTA
2026-11-09 fix(mqtt): correct WiFiClient socket timeout to 3000ms
    [esp32_pressure_tap_node.ino]
2026-11-09 feat(node3): solid onboard LED while pump is ON, OFF when pump is OFF
2026-11-13 Release v1.2.9: 5Hz live stream, 10Hz burst event capture, Node 3 bypass
2026-11-13 Sync dashboard index.html: 5Hz stream, 10Hz burst, Node 3 bypass
2026-11-13 Revert to authentic v1.2.5: direct live waveform, no synthetic smoothing, no Node 3
    [esp32_pressure_tap_node.ino, highres_event_recorder.h]
2026-11-13 chore(platformio): add esp32_ota environment profiles for both nodes
2026-11-13 revert: rollback firmware to version 1.2.1 (direct 1:1 hardware ADC sampling)
    [cloud_ota_updater.h, esp32_pressure_tap_node.ino, esp32_ultrasonic_tank_node.ino, highres_event_recorder.h]
2026-11-13 feat: complete rebuild v1.3.0 with synchronized 1-min Google Sheets, 10Hz event logging, 5Hz live oscilloscope, and Scenario-Aware ESP-NOW & WiFi mesh
2026-11-13 feat: add proxy Wi-Fi JioFiber-Technokind_EXT with WiFiMulti auto-roaming & calibrate for Floor 1 (61.4/73.4 kPa)
2026-11-13 fix(dashboard): eliminate transient zeroing cliff by preserving last valid pressure on partial sync rows & ignoring zero-pressure packets
2026-11-13 fix(firmware): resolve spontaneous reboot loop, stabilize 5Hz live pressure, and fix 10Hz event recording telemetry
    [esp32_pressure_tap_node.ino, highres_event_recorder.h]
